lupoxanesp8266/MonitorizacionISFV/README.md

# Monitorización ISFV
Proyecto consistente en un dispositivo IOT para monitorizar placas solares fotovoltaicas.

Este proyecto pretende construir un medidor de corrientes y tensiones de una instalación solar fotovoltaica o ISFV. 
Para ello se utilizan varios dispositivos de control y medida que se explica detalladamente en el PDF (Manual).

El ESP8266 es el microcontrolador elegido para la monitorización.
Se ha elegido la plataforma THINGER.IO puesto que es gratuita y muy intuitiva.

Cómo implementar el dispositivo de monitorización:

https://raw.githubusercontent.com/lupoxanesp8266/MonitorizacionISFV/master/Manual.pdf 

Esquema Electrónico:

https://raw.githubusercontent.com/lupoxanesp8266/MonitorizacionISFV/master/Esquemas/Electronico.jpg 

Esquema Eléctrico:

https://raw.githubusercontent.com/lupoxanesp8266/MonitorizacionISFV/master/Esquemas/Electrico.jpg
