lupoxanesp8266/MonitorizacionISFV/Esquemas/Electrico.jpg

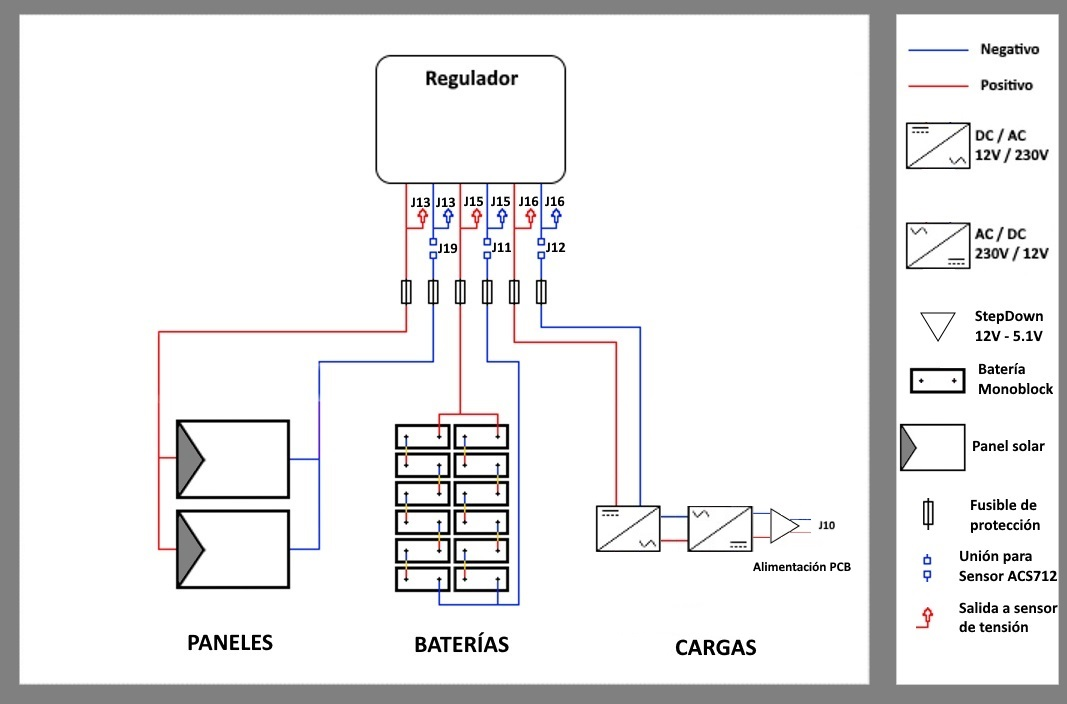
Esquemas/Electrico.jpg
