lupoxanesp8266/MonitorizacionISFV/Esquemas/Electronico.jpg

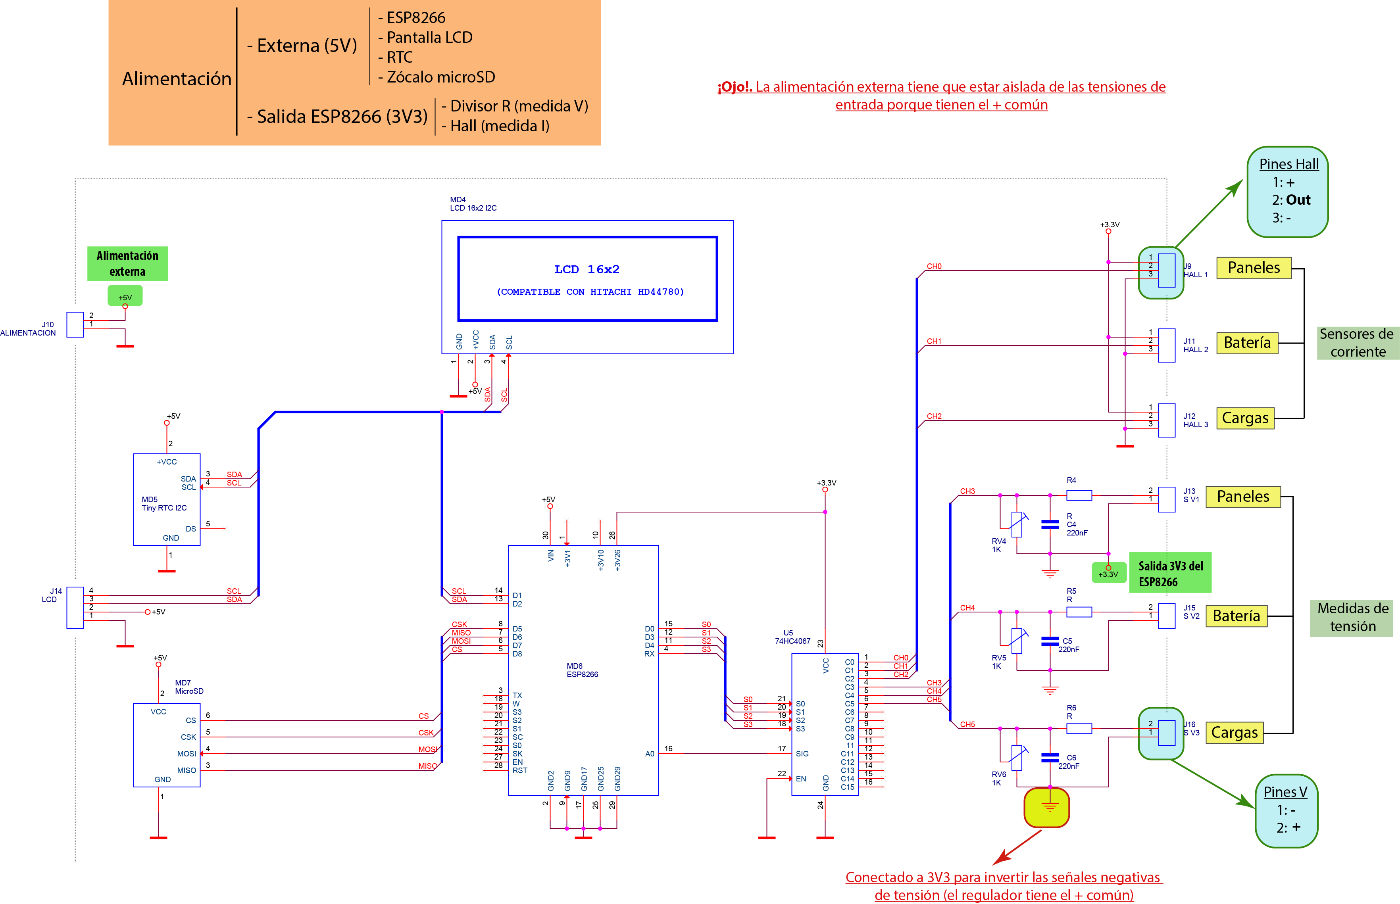
Esquemas/Electronico.jpg
